AlexandruSauca/Audio-Preamplifier-using-Voltage-Control/README.md

# Audio-Preamplifier-using-Voltage-Control
