AlexandruSauca/Audio-Preamplifier-using-Voltage-Control/Proiect1_Sauca_Alexandru.pdf

Universitatea Națională de Știință și Tehnologie POLITEHNICA București Anul universitar 2024-2025

# Proiect 1

# Proiectarea și realizarea unui preamplificator audio cu amplificarea controlată de tensiune

N=2

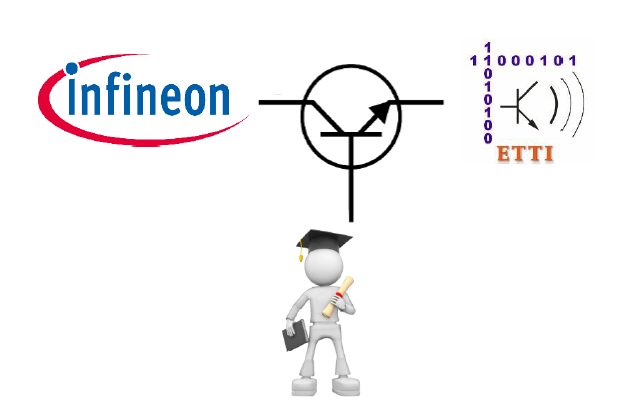
[picture p1: figure]

Coordonatori științifici | Student: Saucă Alexandru Andrei
Prof. dr. ing. Dragoș Dobrescu | grupa 434 B
Ș.l. dr. ing. Mădălin Moise

Cuprins

3.2. Simularea preamplificatorului audio cu control în tensiune cu tensiunea exterioară de

# I. Introducere

Un preamplificator audio cu control în tensiune (VCA) este un amplificator electronic care își variază câșgul în funcție de o tensiune de control (deseori prescurtat CV).
Tensiunea exterioara va permite sa modifica amplificarea semnalului sinusoidal de la intrarea montajului electric.Prin modificarea valorii tensiunii exterioare [0-2V], semnalul de la intrare este amplificat de 0x, 10x, respecv 20x.

# II. Date inițiale de proiectare

2.1. Descrierea temei
Să se proiecteze şi să se realizeze practic un preamplificator de audiofrecvență cu control în tensiune având următoarele caracteristici:
- Tensiunea de alimentare unipolară (VCC=12 V) sau bipolară (VCC=12 V, VEE=-VCC). Semnalizarea prezenței tensiunii cu LED.
- Tensiune de intrare sinusoidală cu amplitudinea cuprinsă între 0 și 20 mV.
- Frecvența semnalului de intrare de 2 kHz.
- Tensiunea continuă de control a amplificării cuprinsă între 0 și 2 V.
- Amplificarea în tensiune controlată cuprinsă între 1 și 20.
- Rezistența de sarcină 700 Ω.

2.2. Schema bloc a montajului electric

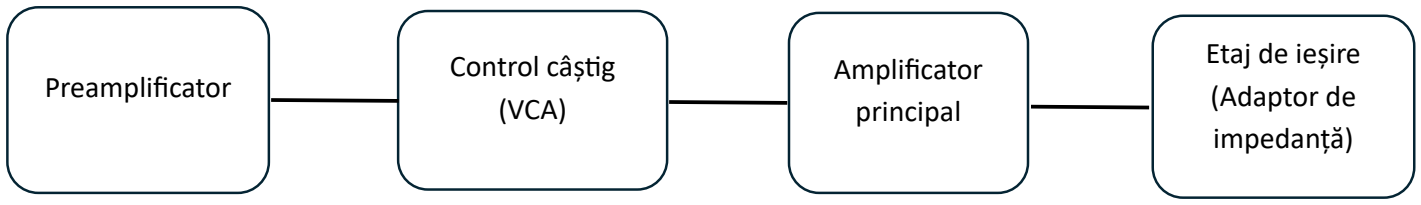
[picture p2: figure]
Preamplificator; Control câșg; (VCA); Amplificator principal; Etaj de ieșire (Adaptor de impedanță)

- Etaj de intrare (Preamplificator):
- Format din tranzistorul Q1Q_1Q1, împreună cu rezistențele R1, R2, R3, și R4, care stabilesc polarizarea și amplificarea.
- Condensatorul C1 servește la cuplarea semnalului de intrare.
- Etaj de amplificare principală (Driver):
- Constituit din tranzistorul Q2cu R5 și R6 configurate pentru stabilirea câștigului și a punctului de funcționare.
- Condensatorul C3 asigură decuplarea pentru stabilitatea semnalului.
- Control al câștigului prin tensiune (Control VCA):
- Format din tranzistorul Q3 și rețeaua de divizare a tensiunii R7 și R8, care reglează polarizarea Q2 printr-o tensiune de control externă (V3).
- Etaj de ieșire (Adaptor de impedanță):
- Include rezistența de sarcină R6 și condensatorul de ieșire C2, care asigură cuplarea semnalului amplificat către ieșirea circuitului.

# III.Conținutul tehnic al proiectului

## 3.1. Schema electrică a montajului electric

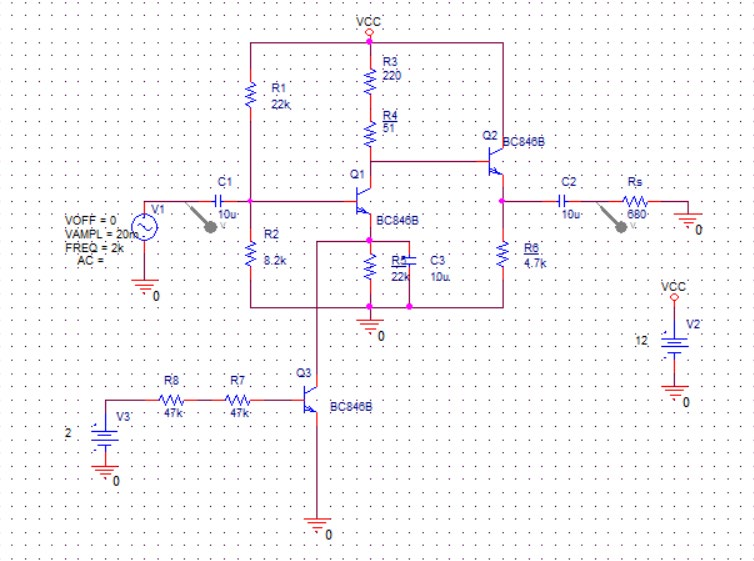
[picture p3: figure]

## 3.2. Simularea preamplificatorului audio cu control în tensiune cu tensiunea exterioară de valoare 0V, 1V, 2V

- Tensiune exterioară de valoare 0V:

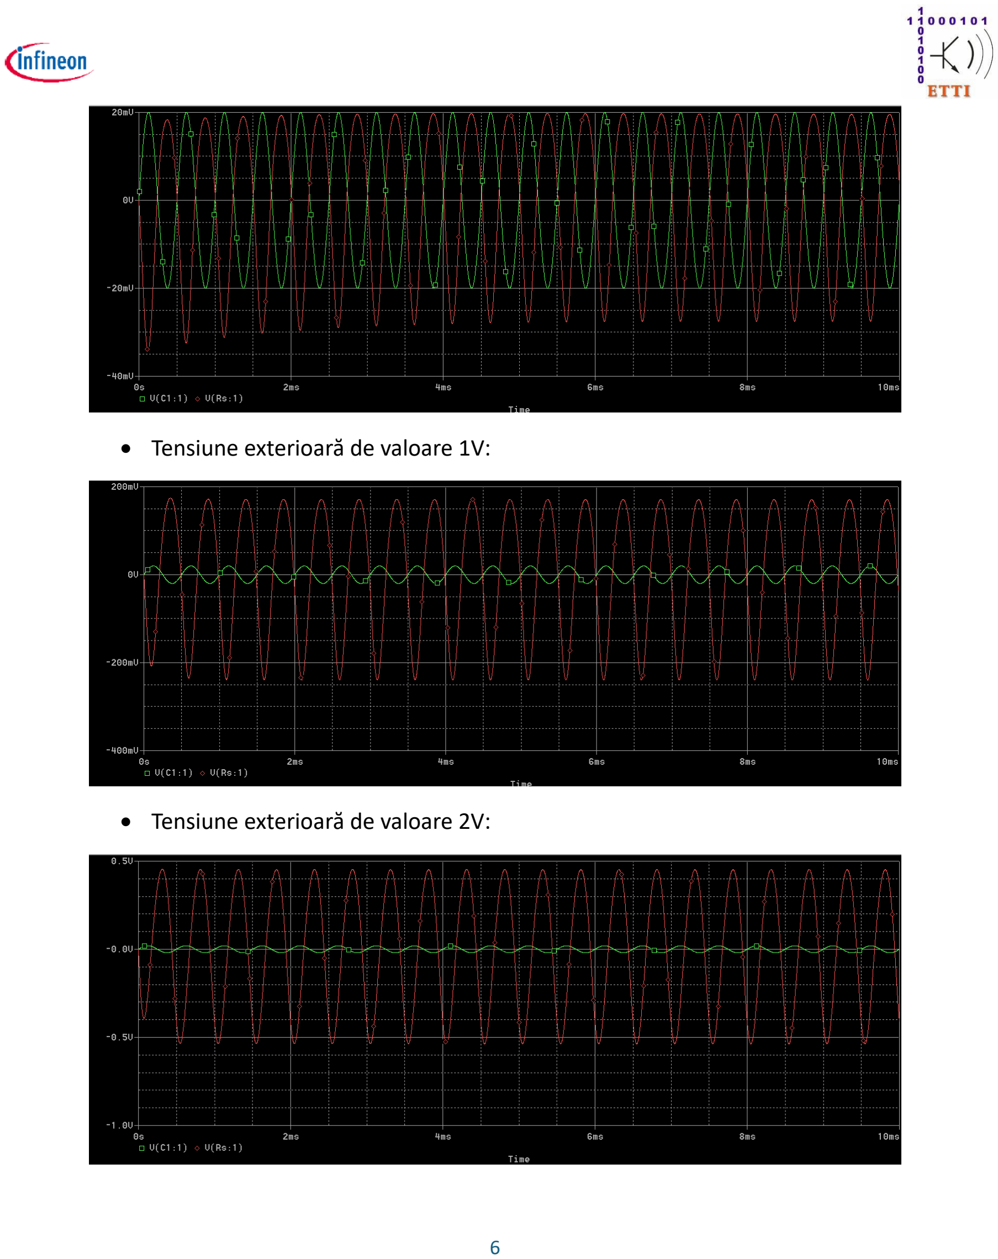
[picture p4: page 6]

- Tensiune exterioară de valoare 1V:
- Tensiune exterioară de valoare 2V:

## 3.3. Puncte stace de funcționare (PSF)

- Curenți

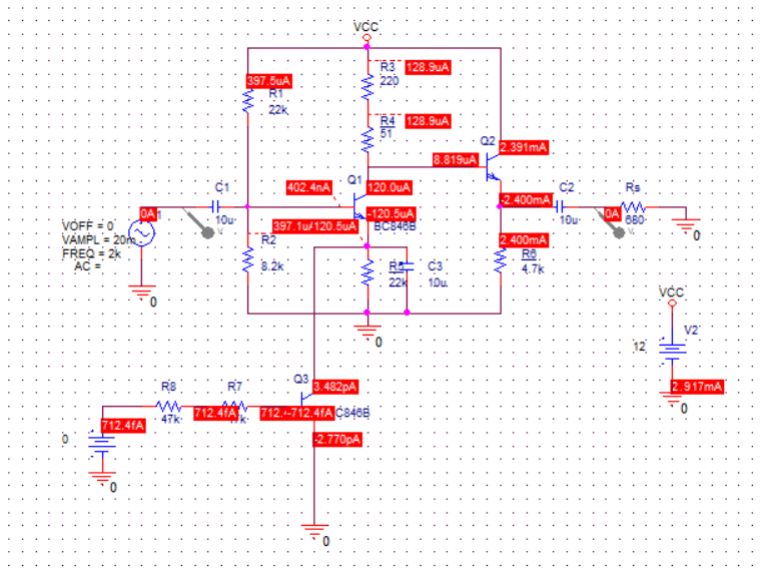
[picture p5: figure]

- Tensiuni

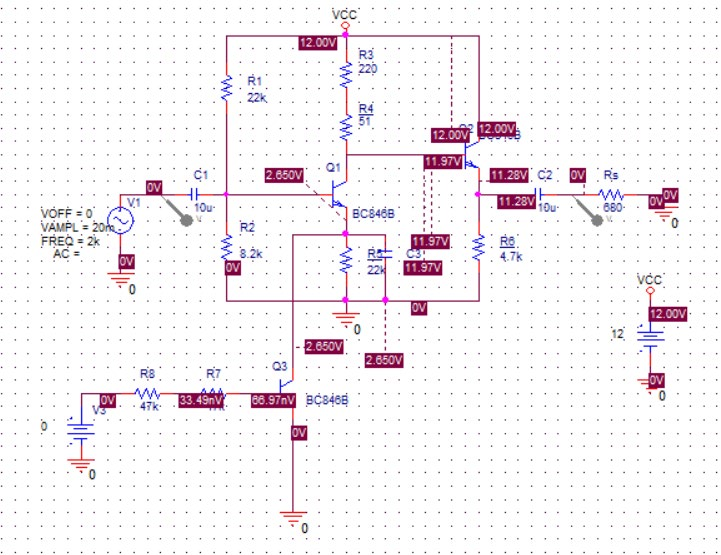
[picture p6: figure]

- Puteri

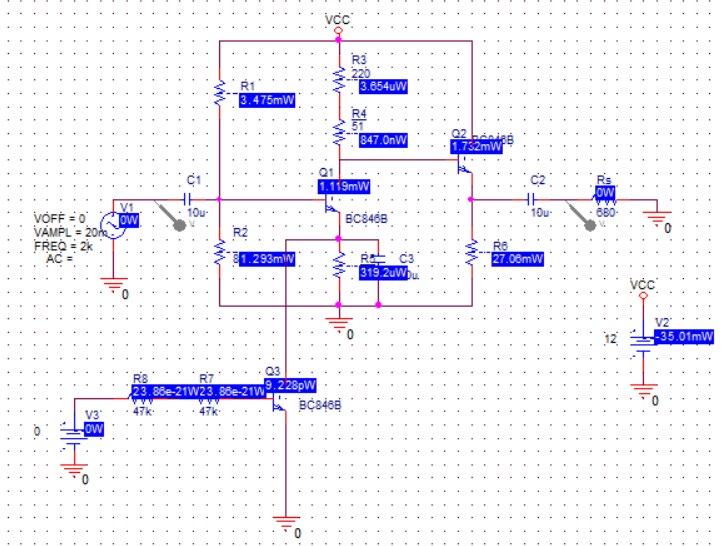
[picture p7: figure]

Calcul analic al PSF:

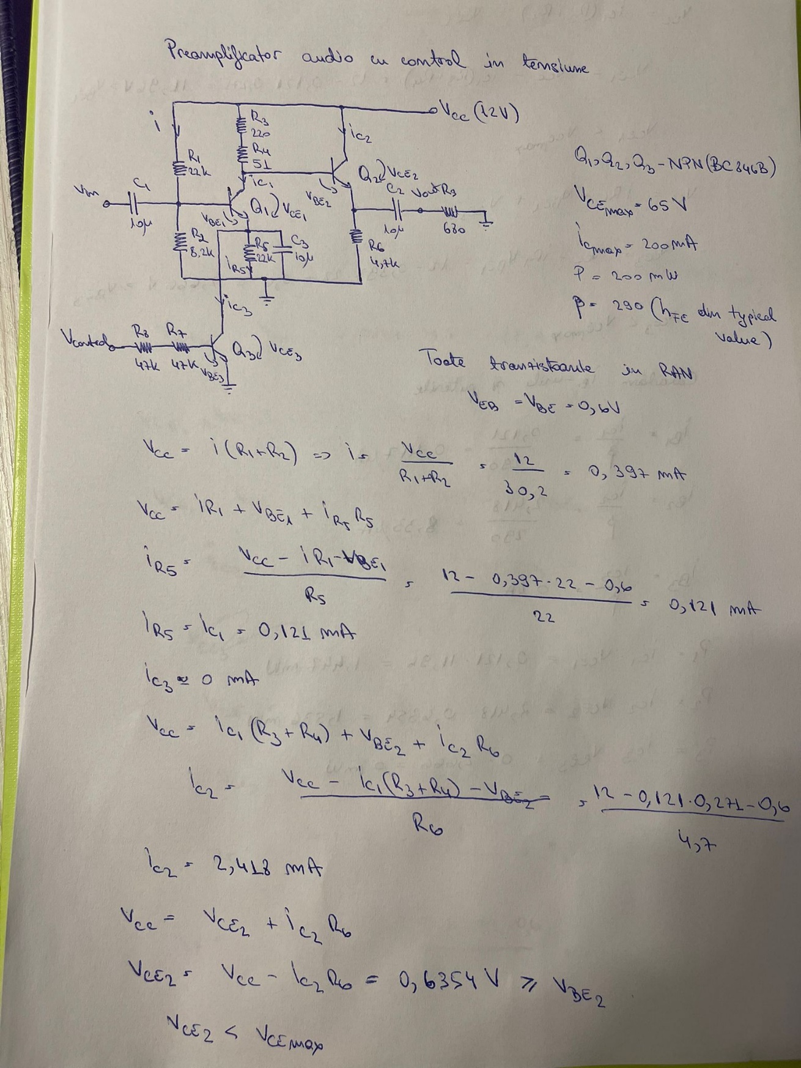
[picture p8: figure]

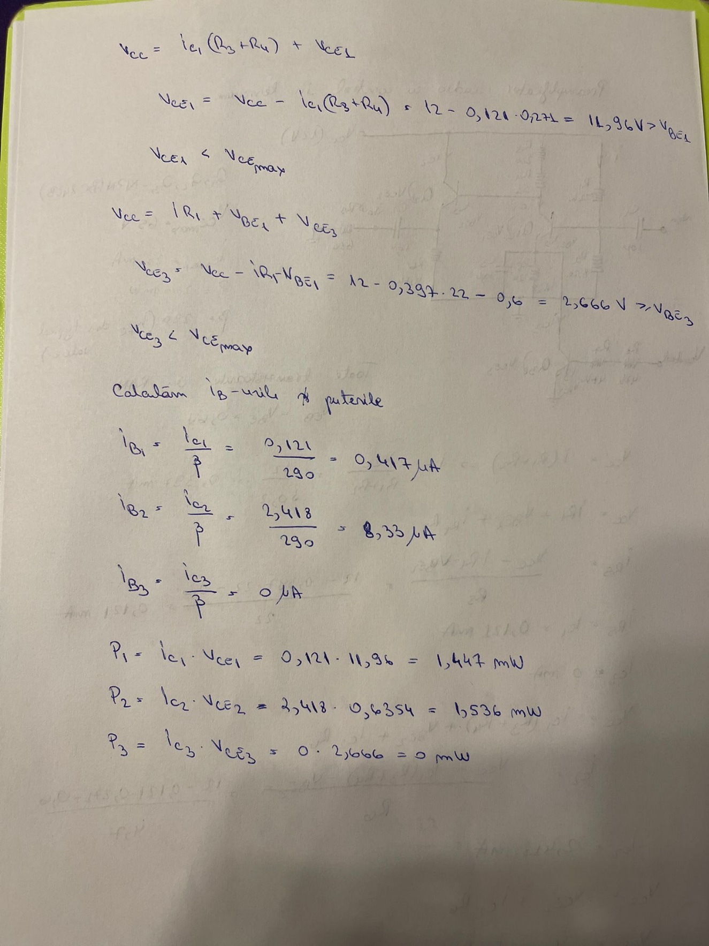
[picture p9: figure]

## 3.4. Bill of Materials

Nr. Crt. | Nume | Catalog | Cod distrib | Nume prod | Prod | Clasă | Qty fix | Qty final | Qty min | Descriere | Distribuitor | Pret (fara TVA) referinta/bu c. TME România | Pret total pe reper (fara TVA) -propus | PCB FOOTPRINT
1 | 51 | (LINK) | SMD0805-51R-5% | 0805S8J051 0T5E | ROYAL OHM | rezistor | | 1 | | Rezistor SMD, chip, 0805, 51Ω, ±5%, 0.125W | TME România | 0.15278 | 0.15278 | SMR0805
2 | 220 | (LINK) | SMD0805-220R-5% | 0805S8J022 1T5E | ROYAL OHM | rezistor | | 1 | | Rezistor SMD, chip, 0805, 220Ω, ±5%, 0.125W | TME România | 0.07571 | 0.07571 | SMR0805
3 | 680 | (LINK) | SMD0805-680R-5% | 0805S8J068 1T5E | ROYAL OHM | rezistor | | 1 | | Rezistor SMD, chip, 0805, 680Ω, ±5%, 0.125W | TME România | 0.07078 | 0.07078 | SMR0805
4 | 4.7k | (LINK) | SMD0805-4K7-5% | 0805S8J047 2T5E | ROYAL OHM | rezistor | | 1 | | Rezistor SMD, chip, 0805, 4.7kΩ, ±5%, 0.125W | TME România | 0.05265 | 0.05265 | SMR0805
5 | 8.2k | (LINK) | SMD0805-8K2-5% | 0805S8J082 2T5E | ROYAL OHM | rezistor | | 1 | | Rezistor SMD, chip, 0805, 8.2kΩ, ±5%, 0.125W | TME România | 0.07078 | 0.07078 | SMR0805
6 | 22k | (LINK) | SMD0805-22K-5% | 0805S8J022 3T5E | ROYAL OHM | rezistor | | 2 | | Rezistor SMD, chip, 0805, 22kΩ, ±5%, 0.125W | TME România | 0.06801 | 0.13602 | SMR0805
7 | 47k | (LINK) | SMD0805-47K-5% | 0805S8J047 3T5E | ROYAL OHM | rezistor | | 2 | | Rezistor: thick film; SMD; 0805; 47kΩ; 0,125W; ±5%; -55÷125°C | TME România | 0.06753 | 0.13506 | SMR0805
8 | 10uF | (LINK) | EEE1HA100 SP | EEE1HA100 SP | PANASONI C | condensator | | 3 | | Condensator : electrolitic; SMD; 10uF; 50V | TME România | 1.154 | 3.462 | CAP_EEE1HA100SP
9 | LED | (LINK) | OF-SMD2012B | OF-SMD2012B | OPTOFLAS H | LED | | 1 | | LED albastru, SMD, 0805, 150-200mcd, 476nm, 120° | TME România | 0.3829 | 0.3829 | SMD0805
10 | NPN | (LINK) | BC846B | BC846B | DIOTEC | tranzistor bipolar | | 3 | | Tranzistor bipolar NPN, SMD, SOT23, 65V, 100mA | TME România | 0.6641 | 1.9923 | SOT23
11 | Conn2p | (LINK) | ZL301-40P | ZL301-40P | NINIGI | Sir pini, pas 2,54mm, SMD | 0 4 | | | Sir pini, pas 2,54mm, SMD, tip tata, bareta de 40 pini | TME România | 0.35895 | 1.4358 | JUMPER2

# IV.Proiectarea și realizarea circuitului in tehnologie SMT și PCB

## 4.1. Imaginea generală a modulului electronic în Layout

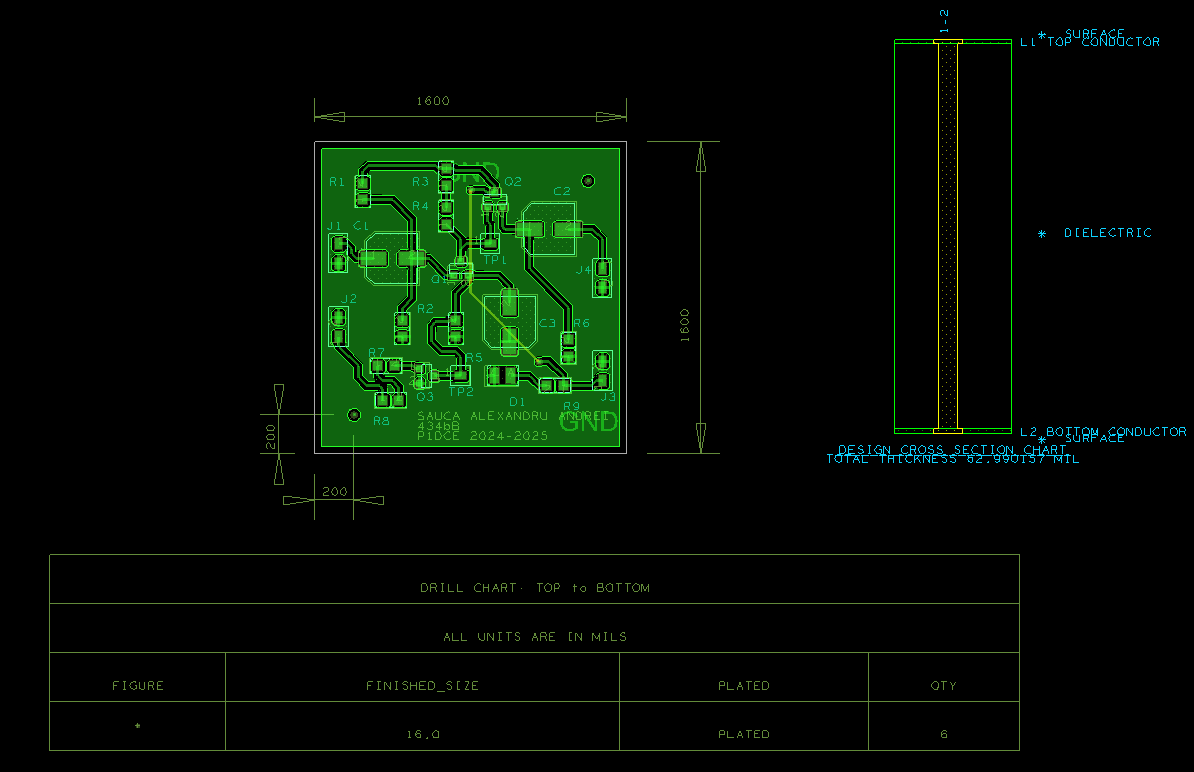
[picture p10: figure]

## 4.2. Imaginea stucturii de interconectare (layer-ul electric TOP)

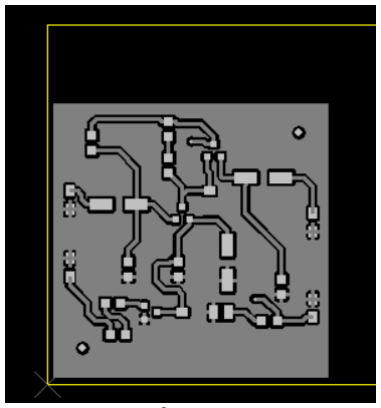
[picture p11: figure]

## 4.3. Imaginea structurii de interconectare (layer-ul electric BOTTOM)

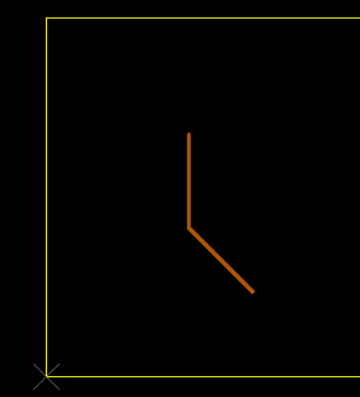
[picture p12: figure]

4.4. Imaginea măși de protecție (layer-ele neelectrice SMTOP,

## SMBOT)

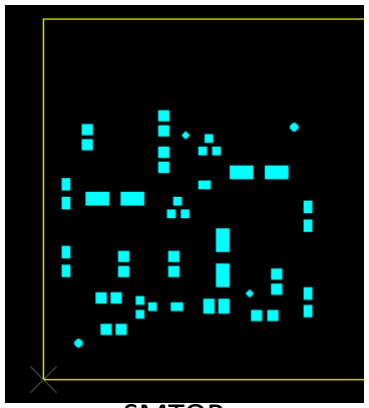
[picture p13: figure]
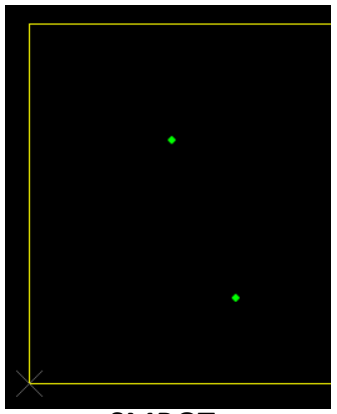
[picture p14: figure]

SMTOP | SMBOT

## 4.5. Imaginea măși de inscripționare (layer-ul neelectric SSTOP)

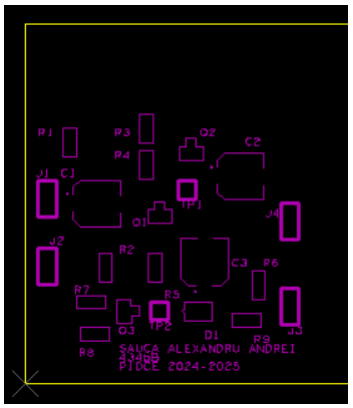
[picture p15: figure]

## 4.6. Imaginea șablonului (layer-ul neelectric SPTOP)

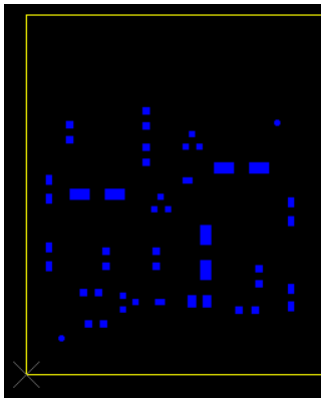
[picture p16: figure]

## 4.7. Imaginea desenului de găurire (NC-Drill)

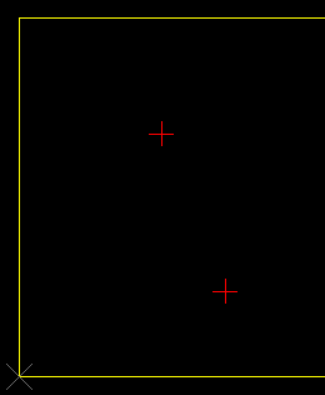
[picture p17: figure]

## 4.8. Imaginea layer-ului neelectric mecanic (FAB)

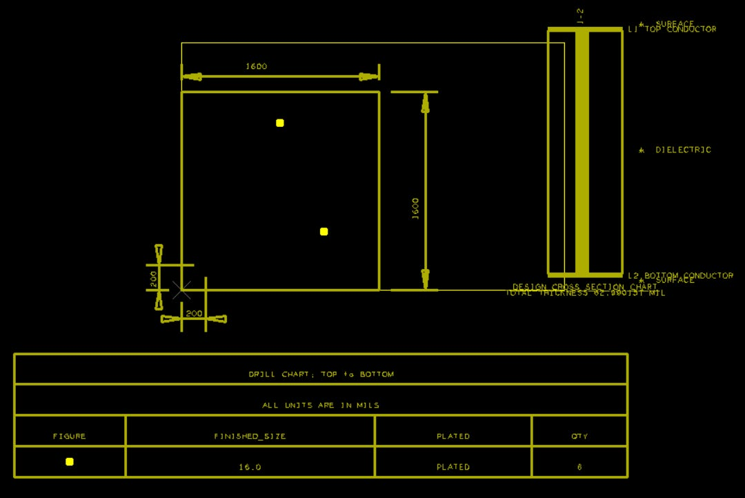
[picture p18: figure]

# V.Asamblare PCB

## 5.1. Unelte necesare

Lipirea componentelor reprezintă fixarea și punerea în contact electric a terminalelor acestora folosind un aliaj p SnAgCu. Pentru acest lucru sunt necesare câteva unelte: stație de lipit, cositor (aliajul de lipire) și flux. Unele aliaje de lipire sunt disponibile cu unul sau mai multe nuclee de flux care trec prin centrul firului de lipire. Acest flux incorporat ajuta procesul de lipire, totuși uneori poate fi nedorit din mai multe move (ex: metoda de curățare după lipire). Fluxul este un agent chimic folosit în procesul de lipire cu principalul scop de pregăre a suprafețelor de lipire prin înlaturarea oxizi.lor și impurităților. Tresa absorbantă pentru extras cositor poate fi folosită pentru refacerea unor lipituri incorecte sau curățarea cositorului în exces.

## 5.2. Procedura de lipire

Temperatura vârfului de lipit se va regla la o temperatură de aproximav 370°C (pentru lipit componentele din acest proiect), iar la finalul procesului de lipire vârful acesteia nu trebuie curățat de cositor pentru a preveni oxidarea lui cât mp nu este folosit. Tresa absorbantă se folosește prin plasarea acesteia între zona de cupru ce se dorește a fi curățată și ciocanul de lipit. Odată ce temperaturea acesteia ajunge la punctul de topire al aliajului va transfera aliajul de pe PCB pe aceasta până se satureaza. Nu este recomadată mișcarea orizontala a acesteia pe PCB deoarece poate desprinde padurile componetelor de pe substrat. Se folosește doar perpendicular pe zonele ce se doresc a fi curățate.

# VI.Manual de ulizare

Generatorul de semnal sinusoidal se conectează la conectorul 1 a montajului electric și se aplică o frecvență de 2kHz cu amplitudine de 20mV.
- Vcc se va conecta la o tensiune de 12V
- A nu se ange componentele sau conexiunile în mpul funcționării
- A se manevra ținându-se de marginile plăcii de asamblare
- A nu se lasa la îndemâna copiilor
- A se feri de umezeală și expunerea îndelungată la razele soarelui

# VII.Concluzii

Proiectul „Preamplificator audio cu control în tensiune” s-a dovedit a fi o inițiavă valoroasă, evidențiind mai multe aspecte esențiale atât în domeniul amplificării semnalelor, cât și în cel al amplificatoarelor. În urma implementării și evaluării, au fost trase concluzii semnificave care subliniază atât punctele forte, cât și posibilele limitări ale proiectului.

În primul rând, sursa exterioară de tensiune a dovedit o performanță solidă, oferind o amplificare a semnalului inițial conform normelor impuse. Avantajele sale notabile includ eficiența în amplificarea semnalelor, oferind o alternavă economică la soluțiile comerciale, fără a compromite calitatea.
Totuși, există și câteva dezavantaje care trebuie luate în considerare. Complexitatea construcției poate reprezenta un obstacol pentru cei mai puțin experimentați în domeniul electronicilor, iar necesitatea unor cunoșnțe tehnice solide poate limita accesul la proiect.

În ceea ce privește domeniile de ulizare, proiectul are potențialul de a aduce contribuții semnificave în mai multe sectoare. În industria muzicală și producția audio, acesta poate fi implementat cu succes pentru ajustarea automată a volumului canalelor în mixerele digitale și analogice. În electronica de consum, poate fi folosit pentru ajustarea automată a câșgului în funcție de scenă. În plus, în medicină și cercetare, proiectul devine un instrument eficent pentru reglarea câșgului pentru captarea semnalelor slabe, cum ar fi sunetele inimii.

În concluzie, proiectul “Preamplificator audio cu control în tensiune” a ans cu succes obiecvele propuse, oferind o plaormă versală și eficientă pentru amplificarea anumitor semnale. Cu toate că există aspecte ce pot fi îmbunătățite, impactul său poziv și potențialul său de aplicare în diverse domenii îl plasează într-o poziție valoroasă în cadrul cercetărilor și dezvoltărilor tehnologice.

# VII.Bibliografie

- Plaorme Laborator Tehnici CAD de Realizare a Modulelor Electronice, Norocel Codreanu
- Plaorme Laborator Tehnici de Interconectare în Electronică, Norocel Codreanu
- Note de curs - Circuite electronice fundamentale, Dan Neculoiu
- Note de curs - Circuite integrate analogice, Cosmin Radu Popa
